dagnall53/ATTINY_RC_Stepper_servo/Initial prototype PCB boards.jpg

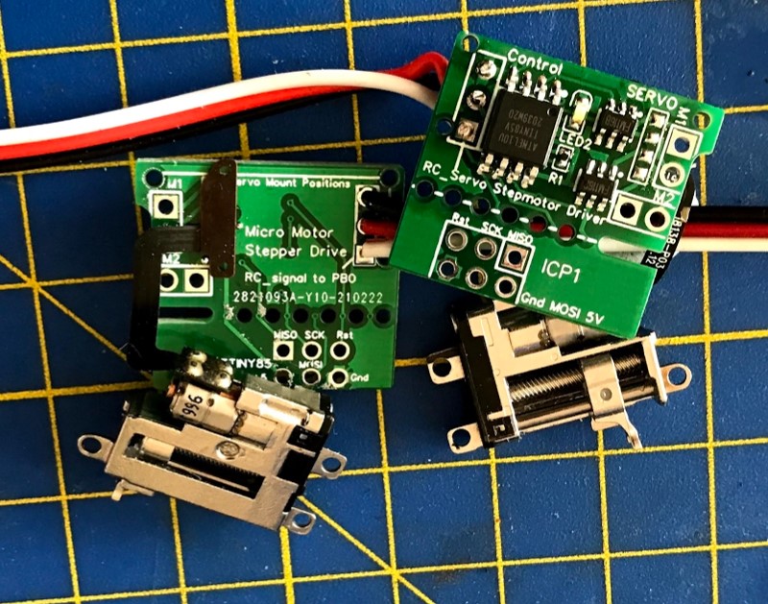
Initial prototype PCB boards.jpg
