dagnall53/ATTINY_RC_Stepper_servo/PCB/Basic Circuit.jpg

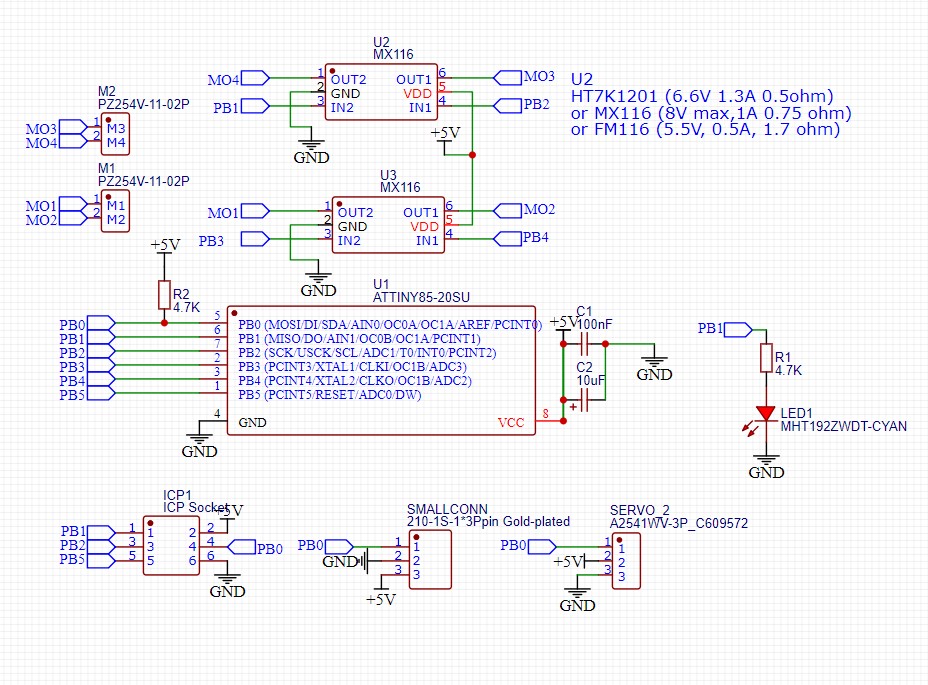
PCB/Basic Circuit.jpg
