dagnall53/ATTINY_RC_Stepper_servo/(list of files, drawings)

Other design files:
PCB/PCB_ForTestProduction_2024-07-03.json
