dagnall53/ATTINY_RC_Stepper_servo/(commit log)

2021-01-17 Update ATTINY_RC_Stepper_servo.ino
    changes for 4 wire micro servo test
2021-02-07 Update ATTINY_RC_Stepper_servo.ino
    Corrected test tone generator to check/set OSCAL and added Motor range measuring code for initial setups to help set gain.
2021-03-05 Update ATTINY_RC_Stepper_servo.ino
    switch analog / digital (end to end operation at threshold (mid) PWM level)
2021-03-20 Update ATTINY_RC_Stepper_Servo.ino
    mod to 16 bit integers!. avoid stupid rollover!
    [ATTINY_RC_Stepper_Servo.ino]
2021-03-21 Create Initial prototype PCB boards.jpg
    Added Photo of test boards
2021-03-23 Update ATTINY_RC_Stepper_Servo.ino
    Mods to deadzone
    Added RST switch to change to Analog mode if 100k fitted RST-Gnd
2021-03-26 Updated Readme
    More information on programming and the PCB.
2021-03-26 Added PCB data
    Revised Folder organisation and added PCB data for revised PCB
    [Final_Design_V2_BOM_2021-03-21.csv]
2021-03-28 increase dynamic rage
    allow PWM to sense widths less than 1ms
    [Final Design-V2_Pick_and_place.csv, Final_Design_V2_BOM_2021-03-21.csv]
2021-03-29 Reverse and V1 board
    Added reverse (setup "zeros" to MAX , and >threshold moves to "0")
    Added pinout for V1 board (untested)
    [ATTINY_RC_Stepper_Servo.ino, Info.h]
2021-03-30 Small updates
    removed V1 board option. There is something wrong with my V1 layout, which had different pinouts, so just avoid and just use the original prototype pcb. Should still work with the V2 pcb as this uses the same pinout.
    [ATTINY_RC_Stepper_Servo.ino]
2021-12-13 Added Boolean Drive mode
    Added #define Servo.
    If commented out, PWM input becomes simple Binary drive from FullScale to 0.
2021-12-15 added back angle
    relieve pressure when finished moving
2022-05-05 A bit more detail added to description
    Also added Circuit Diagram in PCB
    [Final Design-V2_Pick_and_place.csv, Final_Design_V2_BOM_2021-03-21.csv]
2024-07-03 added easy eda file?
    These are the original Easy EDA files, I think?
    I would recommend that the Processor power supply needs to be given some dropout protection.
    If the input power drops (eg steppers take too much power!) then the processor resets.
    Not helpful! I think a big capacitor and diode may help, but have not actually tested.
    Sorry: I have not played with this for some time!
    [PCB_ForTestProduction_2024-07-03.json]
